BrMisha/F405_pill/VESC_VGT_headers/README.md

https://github.com/vedderb/nrf52_vesc/

Change in main.c:
-#define UART_RX                                                        26
-#define UART_TX                                                        25
+#define UART_RX                                                        13
+#define UART_TX                                                        24
