BrMisha/F405_pill/F405_pill_V1.1/TYPE-C-31-M-12/TYPE-C-31-M-12.step

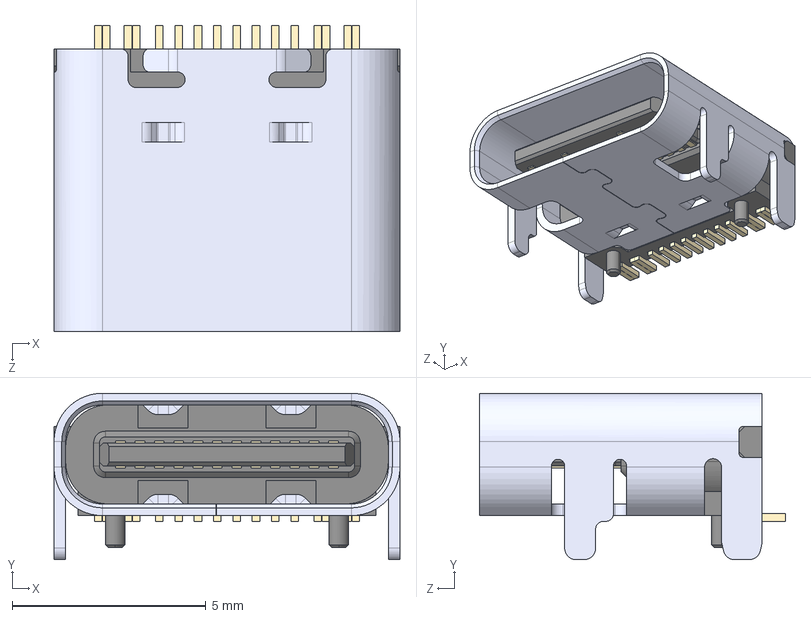
[picture p1: CAD file, 2025-02-10]
F405_pill_V1.1/TYPE-C-31-M-12/TYPE-C-31-M-12.step
8.94 x 4.30 x 7.90 mm
