BrMisha/F405_pill/F405_pill_vgt_V1.0/E73-2G4M08S1C.step

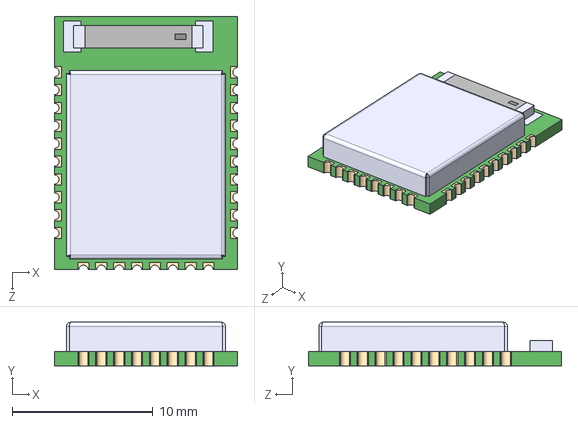
[picture p2: CAD file, 2024-11-16]
F405_pill_vgt_V1.0/E73-2G4M08S1C.step
13.0 x 3.10 x 18.0 mm
