BrMisha/F405_pill/F405_pill_V1.1/F405_pill.kicad_pcb

## KiCad design F405_pill_V1.1/F405_pill.kicad_pcb (2023-09-12)

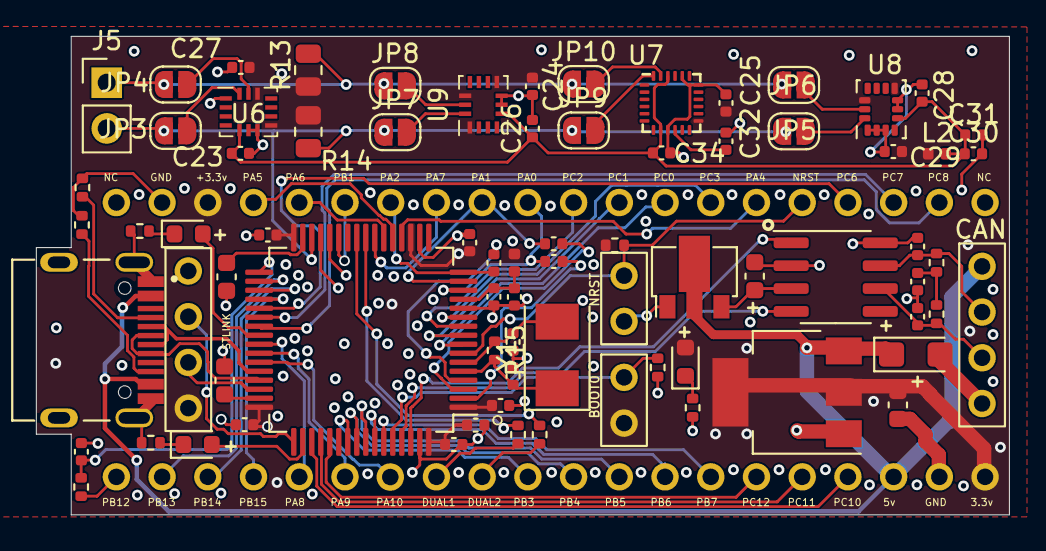
[picture p4: board F405_pill_V1.1/F405_pill.kicad_pcb from above]

Board: 4 copper layers, 54.1 x 26.6 mm, 77 parts (0 on the bottom side), 77 nets.

Parts:
C1: 4u7; C_0402_1005Metric
C2, C4, C7, C10, C12, C17, C18, C19, C23, C24, C25, C26, C27, C28, C29, C32, C34: 100n; C_0402_1005Metric
C3, C6: 20pF; C_0402_1005Metric
C5, C30: 1u; C_0402_1005Metric
C8, C21, C31: 10n; C_0402_1005Metric
C9, C11: 2u2; C_0603_1608Metric
C13: 4.7n; C_0402_1005Metric
C14, C15: 100p; C_0402_1005Metric
C16, C22: 10u; C_0603_1608Metric
C20: 100n; CP_EIA-3216-18_Kemet-A
D1: BLU; LED_0603_1608Metric
D2: GRN; LED_0603_1608Metric
D3: RED; LED_0603_1608Metric
J1, J2: Conn_01x04_Male; my_4_pin
J4: TYPE-C-31-M-12; HRO_TYPE-C-31-M-12
J5: Conn_01x02; PinHeader_1x02_P2.54mm_Vertical
JP1, JP2: Jumper_2_Open; my_2_pin
JP3, JP5, JP7, JP9: SDA; SolderJumper-2_P1.3mm_Open_RoundedPad1.0x1.5mm
JP4, JP6, JP8, JP10: SCL; SolderJumper-2_P1.3mm_Open_RoundedPad1.0x1.5mm
L1, L2: 39n; L_0402_1005Metric
R1, R2: 10k; R_0402_1005Metric
R3, R4: 100Ω; R_0402_1005Metric
R5, R7, R9: 20k; R_0402_1005Metric
R6: 47R; R_0402_1005Metric
R8, R12: 1k; R_0402_1005Metric
R10, R11: 5.1k; R_0402_1005Metric
R13, R14: 2.4K; R_0805_2012Metric
R15: 1M; R_0402_1005Metric
U1: STM32F405RGTx; LQFP-64_10x10mm_P0.5mm
U2: TJA1050T/CM,118; SOIC-8_3.9x4.9mm_P1.27mm
U3: LM1117-3.3; SOT-223-3_TabPin2
U4: STM32F405_pill
U5: HT7550; SOT-89-3
U6: BMI160; Bosch_LGA-14_3x2.5mm_P0.5mm
U7: MPU-9250; InvenSense_QFN-24_3x3mm_P0.4mm
U8: LSM6DS3; LGA-14_3x2.5mm_P0.5mm_LayoutBorder3x4y
U9: BMI270; Bosch_LGA-14_3x2.5mm_P0.5mm
Y1: 8MHz; Crystal_SMD_5032-2Pin_5.0x3.2mm

Connections:
3.3F: C23.1, C26.1, C28.1, C30.1, C31.1, C34.2, L2.2, U6.5 (VDDIO), U7.8 (VDDIO), U7.22 (~CS), U8.5 (VDDIO), U9.5 (VDDIO)
+3.3VA: C5.1, C8.1, L1.2, U1.13 (VDDA)
+3V3: C1.1, C2.1, C4.1, C7.1, C10.1, C12.1, C22.1, C24.1, C25.1, C27.1, C29.1, D1.2 (A), J2.4, JP1.1 (A), L1.1, L2.1, R2.1, R13.1, R14.2, U1.1 (VBAT), U1.19 (VDD), U1.32 (VDD), U1.48 (VDD), U1.64 (VDD), U3.2 (VO), U4.18 (3V3), U4.40 (3V3), U6.8 (VDD), U6.12 (CSB), U7.13 (VDD), U8.8 (VDD), U8.12 (CS), U9.1 (SDO), U9.8 (VDD), U9.12 (CSB)
+5V: C20.1, J1.4, J4.A4B9 (VBUS), J4.B4A9 (VBUS), U3.3 (VI), U4.38 (5V), U5.2 (VI)
DUAL1: R8.1, U4.28 (DUAL1)
DUAL2: R12.1, U4.29 (DUAL2)
GND: C1.2, C2.2, C3.1, C4.2, C5.2, C6.1, C7.2, C8.2, C9.2, C10.2, C11.2, C12.2, C13.2, C14.2, C15.2, C16.2, C20.2, C21.2, C22.2, C23.2, C24.2, C25.2, C26.2, C27.2, C28.2, C29.2, C30.2, C31.2, C32.2, C34.1, J1.1, J2.1, J4.A1B12 (GND), J4.B1A12 (GND), J4.S1 (SHIELD), J4.S2 (SHIELD), J4.S3 (SHIELD), J4.S4 (SHIELD), JP2.2 (B), R1.1, R5.1, R7.1, R9.1, R10.2, R11.2, U1.12 (VSSA), U1.18 (VSS), U1.28 (PB2), U1.63 (VSS), U2.2 (GND), U2.8 (S), U3.1 (GND), U4.19 (GND), U4.39 (GND), U5.1 (GND), U6.1 (SDO), U6.6 (GNDIO), U6.7 (GND), U7.9 (AD0/MISO), U7.18 (GND), U7.20 (RESV_GND), U8.1 (SDO/SA0), U8.2 (SDX), U8.3 (SCX), U8.6 (GND), U8.7 (GND), U9.6 (GNDIO), U9.7 (GND)
NRST: JP2.1 (A), R2.2, U1.7 (NRST), U4.5 (NRST)
unnamed: C13.1, R3.1, R4.2
unnamed: D1.1 (K), R9.2
unnamed: D2.1 (K), R5.2
unnamed: D3.1 (K), R7.2
unnamed: C15.1, J1.2, R4.1, U2.6 (CANL)
unnamed: C14.1, J1.3, R3.2, U2.7 (CANH)
unnamed: J4.A5 (CC1), R10.1
unnamed: J4.B5 (CC2), R11.1
unnamed: JP1.2 (B), R1.2, U1.60 (BOOT0)
unnamed: JP3.2 (B), U6.14 (SDx)
unnamed: JP4.2 (B), U6.13 (SCx)
unnamed: JP5.2 (B), U8.14 (SDA)
unnamed: JP6.2 (B), U8.13 (SCL)
unnamed: JP7.2 (B), U9.14 (SDx)
unnamed: JP8.2 (B), U9.13 (SCx)
unnamed: JP9.2 (B), U7.24 (SDA/MOSI)
unnamed: JP10.2 (B), U7.23 (SCL/SCLK)
unnamed: C3.2, R15.2, U1.5 (PH0), Y1.1
unnamed: C6.2, R15.1, U1.6 (PH1), Y1.2
unnamed: C9.1, U1.31 (VCAP_1)
unnamed: C11.1, U1.47 (VCAP_2)
unnamed: C32.1, U7.10 (REGOUT)
PA0: C17.1, U1.14 (PA0), U4.11 (PA0)
PA1: C18.1, U1.15 (PA1), U4.12 (PA1)
PA2: C19.1, U1.16 (PA2), U4.14 (PA2)
PA4: U1.20 (PA4), U4.6 (PA4)
PA5: U1.21 (PA5), U4.17 (PA5)
PA6: U1.22 (PA6), U4.16 (PA6)
PA7: U1.23 (PA7), U4.13 (PA7)
PA8: U1.41 (PA8), U4.25 (PA8)
PA9: U1.42 (PA9), U4.26 (PA9)
PA10: U1.43 (PA10), U4.27 (PA10)
PA15: D2.2 (A), U1.50 (PA15)
PB1: U1.27 (PB1), U4.15 (PB1)
PB3: U1.55 (PB3), U4.30 (PB3)
PB4: U1.56 (PB4), U4.31 (PB4)
PB5: U1.57 (PB5), U4.32 (PB5)
PB6: U1.58 (PB6), U4.33 (PB6)
PB7: U1.59 (PB7), U4.34 (PB7)
PB8: U1.61 (PB8), U2.4 (RXD)
PB9: U1.62 (PB9), U2.1 (TXD)
PB10: J5.1, JP4.1 (A), JP6.1 (A), JP8.1 (A), JP10.1 (A), R13.2, U1.29 (PB10)
PB11: J5.2, JP3.1 (A), JP5.1 (A), JP7.1 (A), JP9.1 (A), R14.1, U1.30 (PB11)
PB12: C21.1, R6.1, U1.33 (PB12)
PB13: U1.34 (PB13), U4.22 (PB13)
PB14: U1.35 (PB14), U4.23 (PB14)
PB15: U1.36 (PB15), U4.24 (PB15)
PC0: U1.8 (PC0), U4.8 (PC0)
PC1: U1.9 (PC1), U4.9 (PC1)
PC2: U1.10 (PC2), U4.10 (PC2)
PC3: U1.11 (PC3), U4.7 (PC3)
PC4: R8.2, U1.24 (PC4)
PC5: R12.2, U1.25 (PC5)
PC6: U1.37 (PC6), U4.4 (PC6)
PC7: U1.38 (PC7), U4.3 (PC7)
PC8: U1.39 (PC8), U4.2 (PC8)
PC9: D3.2 (A), U1.40 (PC9)
PC10: U1.51 (PC10), U4.37 (PC10)
PC11: U1.52 (PC11), U4.36 (PC11)
PC12: U1.53 (PC12), U4.35 (PC12)
PC13: C17.2, U1.2 (PC13)
PC14: C18.2, U1.3 (PC14)
PC15: C19.2, U1.4 (PC15)
SWCLK: J2.2, U1.49 (PA14)
SWDIO: J2.3, U1.46 (PA13)
USB_D+: J4.A6 (DP1), J4.B6 (DP2), U1.45 (PA12)
USB_D-: J4.A7 (DN1), J4.B7 (DN2), U1.44 (PA11)
VDO_I: C16.1, U2.3 (VCC), U5.3 (VO)
_PB12: R6.2, U4.21 (PB12)
