BrMisha/F405_pill/F405_pill_vgt_V1.0/F405_pill.kicad_pcb

## KiCad design F405_pill_vgt_V1.0/F405_pill.kicad_pcb (2025-01-16)

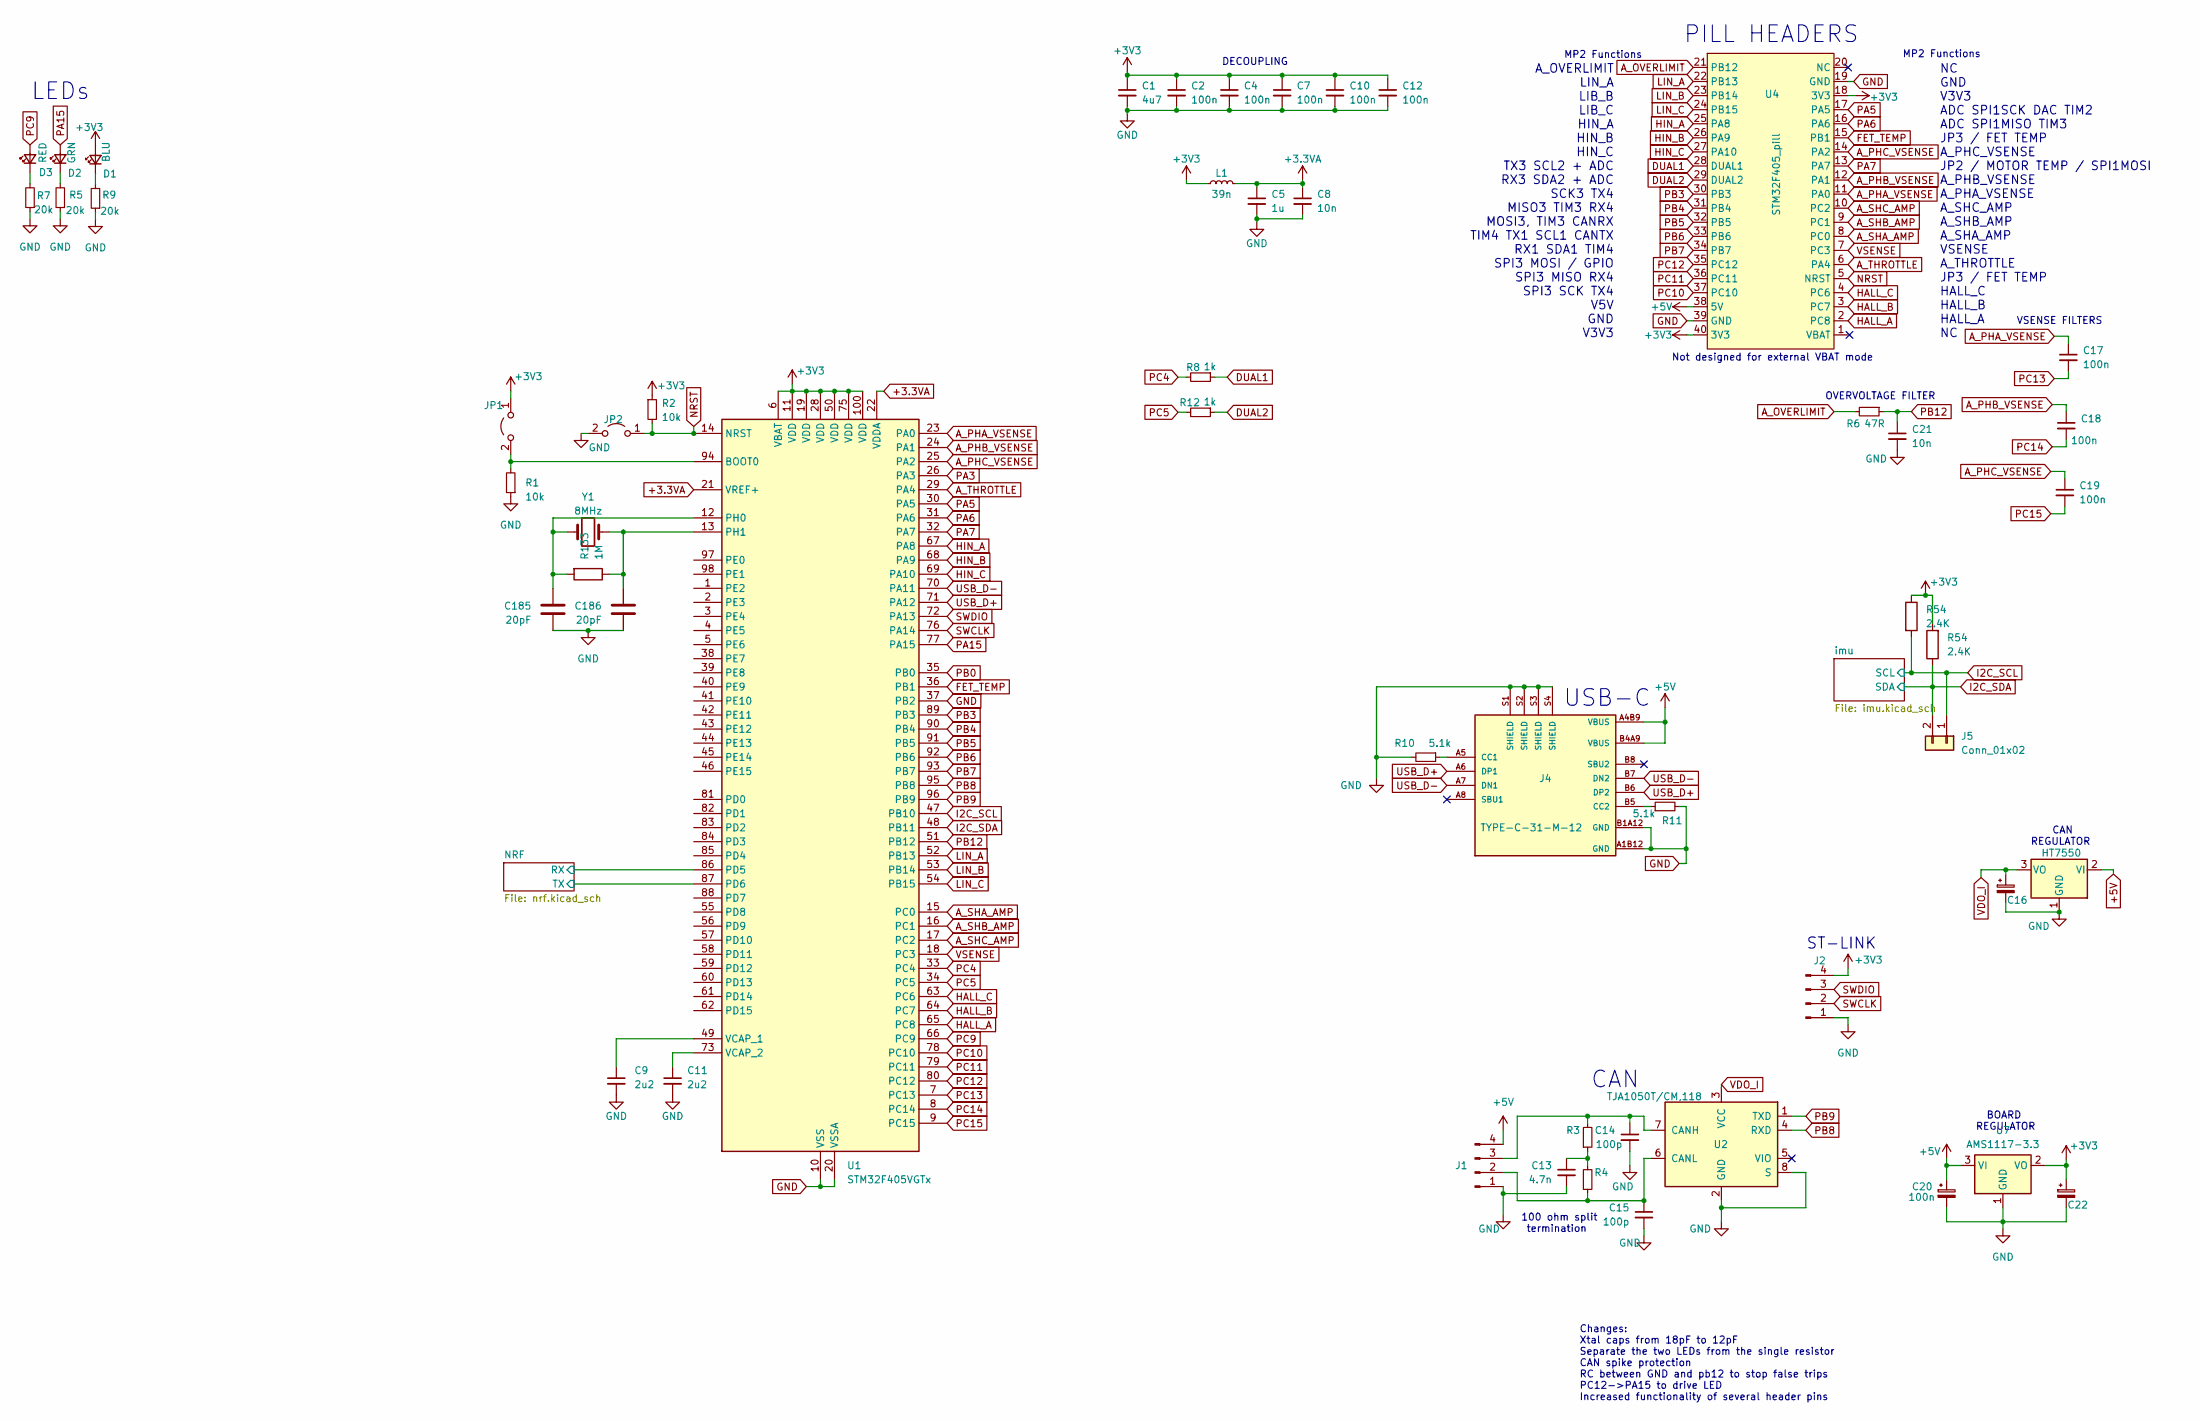
[picture p5: schematic F405_pill.kicad_sch]

Parts:
C1: 4u7; C_0402_1005Metric; LCSC C23733
C2, C4, C7, C10, C12, C17, C18, C19: 100n; C_0402_1005Metric; LCSC C1525
C5: 1u; C_0402_1005Metric; LCSC C52923
C8, C21: 10n; C_0402_1005Metric; LCSC C15195
C9, C11: 2u2; C_0603_1608Metric; LCSC C23630
C13: 4.7n; C_0402_1005Metric; LCSC C1538
C14, C15: 100p; C_0402_1005Metric; LCSC C1546
C16, C22: 10u; C_0603_1608Metric; LCSC C962635
C20: 100n; CP_EIA-3216-18_Kemet-A; LCSC C122257
C185, C186: 20pF; C_0402_1005Metric; MPN C1554
D1: BLU; LED_0603_1608Metric; LCSC C72041
D2: GRN; LED_0603_1608Metric; LCSC C72043
D3: RED; LED_0603_1608Metric; LCSC C2286
J1, J2: Conn_01x04_Male; my_4_pin
J4: TYPE-C-31-M-12; HRO_TYPE-C-31-M-12; PARTREV A; LCSC C165948
J5: Conn_01x02; PinHeader_1x02_P2.54mm_Vertical
JP1, JP2: Jumper_2_Open; my_2_pin
L1: 39n; L_0402_1005Metric; LCSC C26443
R1, R2: 10k; R_0402_1005Metric; LCSC C25744
R3, R4: 100Ω; R_0402_1005Metric; LCSC C25076
R5, R7, R9: 20k; R_0402_1005Metric; LCSC C25765
R6: 47R; R_0402_1005Metric; LCSC C25118
R8, R12: 1k; R_0402_1005Metric; LCSC C11702
R10, R11: 5.1k; R_0402_1005Metric; LCSC C25905
R54: 2.4K; R_0805_2012Metric; MPN C17526
R133: 1M; R_0402_1005Metric; MPN C26083
U1: STM32F405VGTx; LQFP-100_14x14mm_P0.5mm; LCSC C56621
U2: TJA1050T/CM,118; SOIC-8_3.9x4.9mm_P1.27mm; LCSC C6952
U4: STM32F405_pill
U5: HT7550; SOT-89-3; LCSC C16106
U7: AMS1117-3.3; SOT-223-3_TabPin2; MPN C6186
Y1: 8MHz; Crystal_SMD_5032-2Pin_5.0x3.2mm; MPN C115962

Connections:
+3.3VA: C5.1, C8.1, L1.2, U1.21 (VREF+), U1.22 (VDDA)
+3V3: C1.1, C2.1, C4.1, C7.1, C10.1, C12.1, C22.1, D1.2 (A), J2.4, JP1.1 (A), L1.1, R2.1, U1.6 (VBAT), U1.11 (VDD), U1.19 (VDD), U1.28 (VDD), U1.50 (VDD), U1.75 (VDD), U1.100 (VDD), U4.18 (3V3), U4.40 (3V3), U7.2 (VO); also elsewhere on the board
+5V: C20.1, J1.4, J4.A4B9 (VBUS), J4.B4A9 (VBUS), U4.38 (5V), U5.2 (VI), U7.3 (VI)
/NRF/RX: U1.86 (PD5); also elsewhere on the board
/NRF/TX: U1.87 (PD6); also elsewhere on the board
A_OVERLIMIT: R6.2, U4.21 (PB12)
A_PHA_VSENSE: C17.1, U1.23 (PA0), U4.11 (PA0)
A_PHB_VSENSE: C18.1, U1.24 (PA1), U4.12 (PA1)
A_PHC_VSENSE: C19.1, U1.25 (PA2), U4.14 (PA2)
A_SHA_AMP: U1.15 (PC0), U4.8 (PC0)
A_SHB_AMP: U1.16 (PC1), U4.9 (PC1)
A_SHC_AMP: U1.17 (PC2), U4.10 (PC2)
A_THROTTLE: U1.29 (PA4), U4.6 (PA4)
DUAL1: R8.1, U4.28 (DUAL1)
DUAL2: R12.1, U4.29 (DUAL2)
FET_TEMP: U1.36 (PB1), U4.15 (PB1)
GND: C1.2, C2.2, C4.2, C5.2, C7.2, C8.2, C9.2, C10.2, C11.2, C12.2, C13.2, C14.2, C15.2, C16.2, C20.2, C21.2, C22.2, J1.1, J2.1, J4.A1B12 (GND), J4.B1A12 (GND), J4.S1 (SHIELD), J4.S2 (SHIELD), J4.S3 (SHIELD), J4.S4 (SHIELD), JP2.2 (B), R1.1, R5.1, R7.1, R9.1, R10.2, R11.2, U1.10 (VSS), U1.20 (VSSA), U1.27 (VSS), U1.37 (PB2), U1.74 (VSS), U1.99 (VSS), U2.2 (GND), U2.8 (S), U4.19 (GND), U4.39 (GND), U5.1 (GND), U7.1 (GND); also elsewhere on the board
HALL_A: U1.65 (PC8), U4.2 (PC8)
HALL_B: U1.64 (PC7), U4.3 (PC7)
HALL_C: U1.63 (PC6), U4.4 (PC6)
HIN_A: U1.67 (PA8), U4.25 (PA8)
HIN_B: U1.68 (PA9), U4.26 (PA9)
HIN_C: U1.69 (PA10), U4.27 (PA10)
I2C_SCL: J5.1, U1.47 (PB10); also elsewhere on the board
I2C_SDA: J5.2, U1.48 (PB11); also elsewhere on the board
LIN_A: U1.52 (PB13), U4.22 (PB13)
LIN_B: U1.53 (PB14), U4.23 (PB14)
LIN_C: U1.54 (PB15), U4.24 (PB15)
NRST: JP2.1 (A), R2.2, U1.14 (NRST), U4.5 (NRST)
unnamed: C13.1, R3.1, R4.2
unnamed: D1.1 (K), R9.2
unnamed: D2.1 (K), R5.2
unnamed: D3.1 (K), R7.2
unnamed: C15.1, J1.2, R4.1, U2.6 (CANL)
unnamed: C14.1, J1.3, R3.2, U2.7 (CANH)
unnamed: J4.A5 (CC1), R10.1
unnamed: J4.B5 (CC2), R11.1
unnamed: JP1.2 (B), R1.2, U1.94 (BOOT0)
unnamed 41: U1.12 (PH0), Y1.1; also elsewhere on the board
unnamed 42: U1.13 (PH1), Y1.2; also elsewhere on the board
unnamed: C9.1, U1.49 (VCAP_1)
unnamed: C11.1, U1.73 (VCAP_2)
PA3: U1.26 (PA3)
PA5: U1.30 (PA5), U4.17 (PA5)
PA6: U1.31 (PA6), U4.16 (PA6)
PA7: U1.32 (PA7), U4.13 (PA7)
PA15: D2.2 (A), U1.77 (PA15)
PB0: U1.35 (PB0)
PB3: U1.89 (PB3), U4.30 (PB3)
PB4: U1.90 (PB4), U4.31 (PB4)
PB5: U1.91 (PB5), U4.32 (PB5)
PB6: U1.92 (PB6), U4.33 (PB6)
PB7: U1.93 (PB7), U4.34 (PB7)
PB8: U1.95 (PB8), U2.4 (RXD)
PB9: U1.96 (PB9), U2.1 (TXD)
PB12: C21.1, R6.1, U1.51 (PB12)
PC4: R8.2, U1.33 (PC4)
PC5: R12.2, U1.34 (PC5)
PC9: D3.2 (A), U1.66 (PC9)
PC10: U1.78 (PC10), U4.37 (PC10)
PC11: U1.79 (PC11), U4.36 (PC11)
PC12: U1.80 (PC12), U4.35 (PC12)
PC13: C17.2, U1.7 (PC13)
PC14: C18.2, U1.8 (PC14)
PC15: C19.2, U1.9 (PC15)
SWCLK: J2.2, U1.76 (PA14)
SWDIO: J2.3, U1.72 (PA13)
USB_D+: J4.A6 (DP1), J4.B6 (DP2), U1.71 (PA12)
USB_D-: J4.A7 (DN1), J4.B7 (DN2), U1.70 (PA11)
VDO_I: C16.1, U2.3 (VCC), U5.3 (VO)
VSENSE: U1.18 (PC3), U4.7 (PC3)

Notes on the sheet:
CAN
NC GND V3V3 ADC SPI1SCK DAC TIM2 ADC SPI1MISO TIM3 JP3 / FET TEMP A_PHC_VSENSE JP2 / MOTOR TEMP / SPI1MOSI A_PHB_VSENSE A_PHA_VSENSE A_SHC_AMP A_SHB_AMP A_SHA_AMP VSENSE A_THROTTLE JP3 / FET TEMP HALL_C HALL_B HALL_A NC
ST-LINK
Changes: Xtal caps from 18pF to 12pF Separate the two LEDs from the single resistor CAN spike protection RC between GND and pb12 to stop false trips PC12->PA15 to drive LED Increased functionality of several header pins
A_OVERLIMIT LIN_A LIB_B LIB_C HIN_A HIN_B HIN_C TX3 SCL2 + ADC RX3 SDA2 + ADC SCK3 TX4 MISO3 TIM3 RX4 MOSI3, TIM3 CANRX TIM4 TX1 SCL1 CANTX RX1 SDA1 TIM4 SPI3 MOSI / GPIO SPI3 MISO RX4 SPI3 SCK TX4 V5V GND V3V3
BOARD REGULATOR
PILL HEADERS
MP2 Functions
CAN REGULATOR
VSENSE FILTERS
OVERVOLTAGE FILTER
LEDs
USB-C
Not designed for external VBAT mode
DECOUPLING
100 ohm split termination

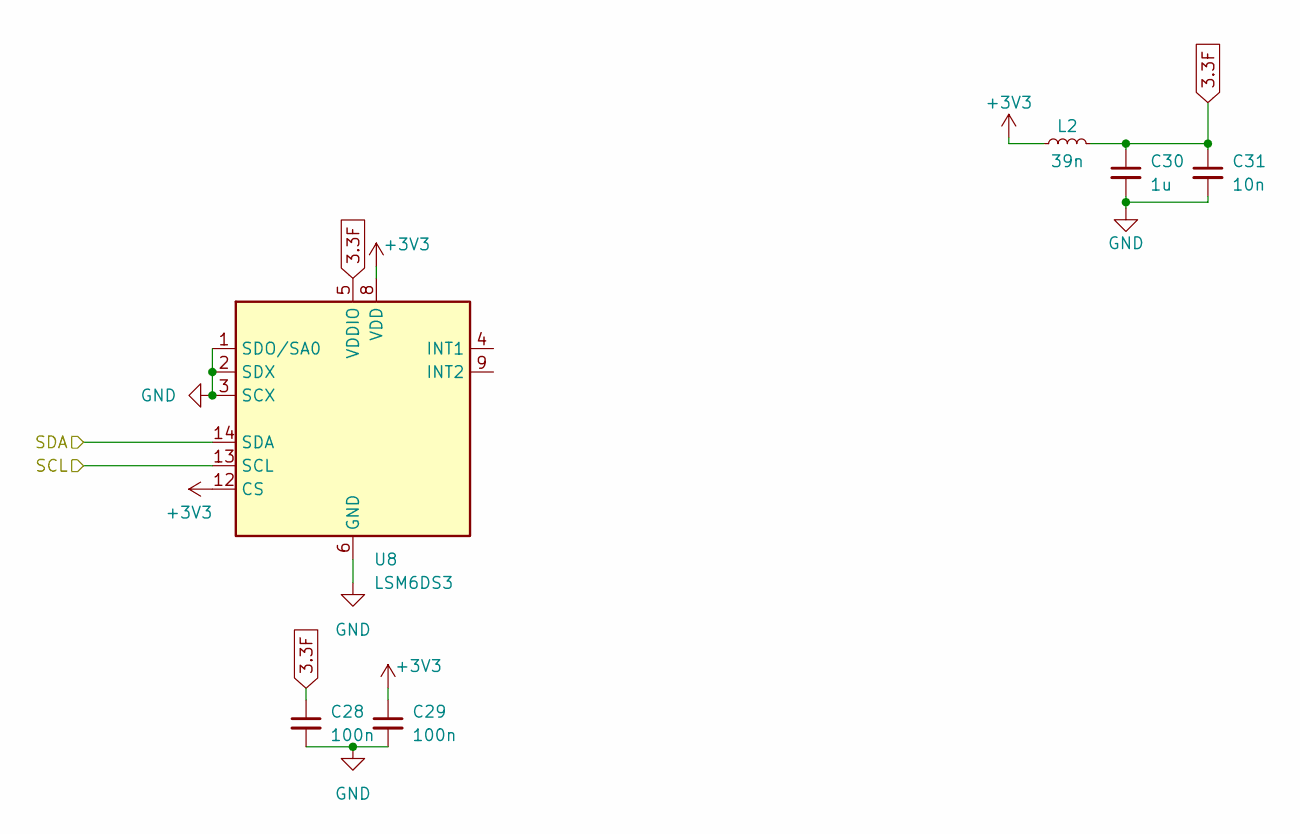
[picture p6: schematic imu.kicad_sch]

Parts:
C28, C29: 100n; C_0402_1005Metric; LCSC C1525
C30: 1u; C_0402_1005Metric; LCSC C52923
C31: 10n; C_0402_1005Metric; LCSC C15195
L2: 39n; L_0402_1005Metric; LCSC C26443
U8: LSM6DS3; LGA-14_3x2.5mm_P0.5mm_LayoutBorder3x4y; MPN C95230

Connections:
3.3F: C28.1, C30.1, C31.1, L2.2, U8.5 (VDDIO)
+3V3: C29.1, L2.1, U8.8 (VDD), U8.12 (CS); also elsewhere on the board
GND: C28.2, C29.2, C30.2, C31.2, U8.1 (SDO/SA0), U8.2 (SDX), U8.3 (SCX), U8.6 (GND), U8.7 (GND); also elsewhere on the board
I2C_SCL: U8.13 (SCL); also elsewhere on the board
I2C_SDA: U8.14 (SDA); also elsewhere on the board

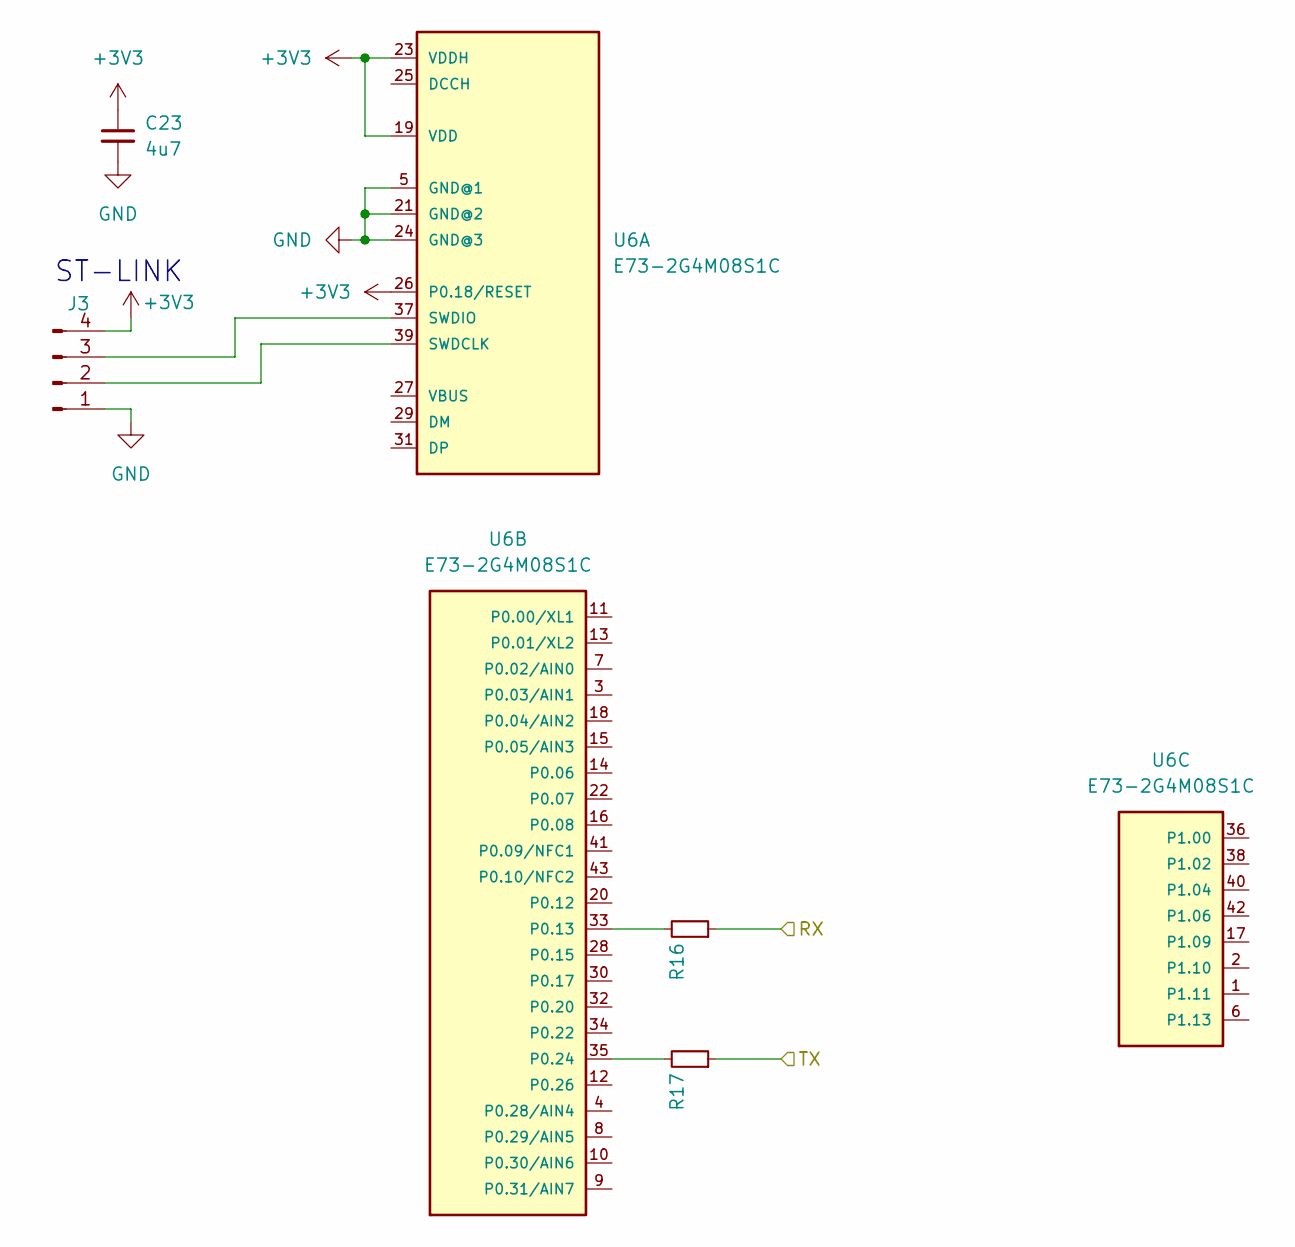
[picture p7: schematic nrf.kicad_sch]

Parts:
C23: 4u7; C_0402_1005Metric; LCSC C23733
J3: Conn_01x04_Male; PinHeader_1x04_P2.54mm_Vertical
R16, R17: 100Ω; R_0402_1005Metric; LCSC C25076
U6: E73-2G4M08S1C

Connections:
+3V3: C23.1, J3.4, U6.19 (VDD), U6.23 (VDDH), U6.26 (P0.18/RESET); also elsewhere on the board
/NRF/RX: R16.1; also elsewhere on the board
/NRF/TX: R17.1; also elsewhere on the board
GND: C23.2, J3.1, U6.5 (GND@1), U6.21 (GND@2), U6.24 (GND@3); also elsewhere on the board
unnamed: J3.2, U6.39 (SWDCLK)
unnamed: J3.3, U6.37 (SWDIO)
unnamed: R16.2, U6.33 (P0.13)
unnamed: R17.2, U6.35 (P0.24)

Notes on the sheet:
ST-LINK

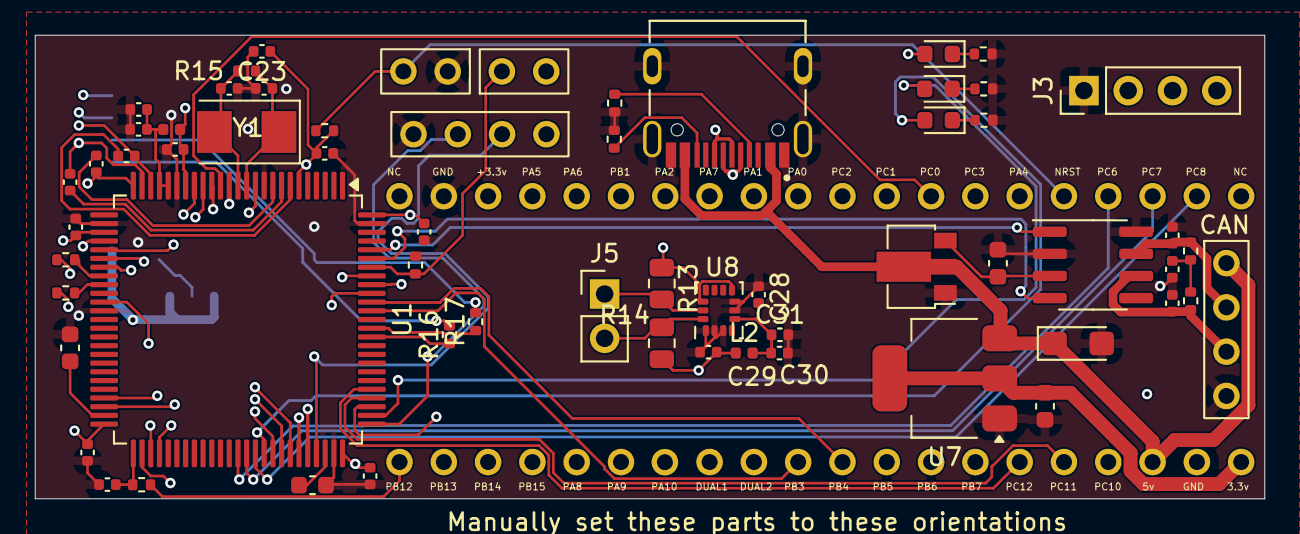
[picture p8: board F405_pill_vgt_V1.0/F405_pill.kicad_pcb from above]

Board: 4 copper layers, 70.5 x 26.6 mm, 64 parts (1 on the bottom side), 74 nets.

Other parts of the board:
C3, C6: 20pF; C_0402_1005Metric
R13, R14: 2.4K; R_0805_2012Metric
R15: 1M; R_0402_1005Metric

Their connections:
+3V3: R13.1, R14.2; also elsewhere on the board
GND: C3.1, C6.1; also elsewhere on the board
I2C_SCL: R13.2; also elsewhere on the board
I2C_SDA: R14.1; also elsewhere on the board
unnamed 41: C3.2, R15.2; also elsewhere on the board
unnamed 42: C6.2, R15.1; also elsewhere on the board
