BrMisha/F405_pill/F405_pill.ioc

Mcu.UserName=STM32F405VGTx
PA0-WKUP.GPIO_Label=A_PHA_VSENSE
PA0-WKUP.Signal=GPIO_Input
PA1.GPIO_Label=A_PHB_VSENSE
PA1.Signal=GPIO_Input
PA10.GPIO_Label=HIN_C
PA10.Signal=GPIO_Output
PA11.Signal=USB_OTG_FS_DM
PA12.Signal=USB_OTG_FS_DP
PA2.GPIO_Label=A_PHC_VSENSE
PA2.Signal=GPIO_Input
PA4.GPIO_Label=A_THROTTLE
PA4.Signal=GPIO_Analog
PA8.GPIO_Label=HIN_A
PA8.Signal=GPIO_Output
PA9.GPIO_Label=HIN_B
PA9.Signal=GPIO_Output
PB1.GPIO_Label=FET_TEMP
PB1.Signal=GPIO_Analog
PB10.Signal=I2C2_SCL
PB11.Signal=I2C2_SDA
PB12.GPIO_Label=A_OVERLIMIT
PB12.Signal=GPIO_Analog
PB13.GPIO_Label=LIN_A
PB13.Signal=GPIO_Output
PB14.GPIO_Label=LIN_B
PB14.Signal=GPIO_Output
PB15.GPIO_Label=LIN_C
PB15.Signal=GPIO_Output
PC0.GPIO_Label=A_SHA_AMP
PC0.Signal=GPIO_Analog
PC1.GPIO_Label=A_SHB_AMP
PC1.Signal=GPIO_Analog
PC10.Signal=USART3_TX
PC11.Signal=USART3_RX
PC2.GPIO_Label=A_SHC_AMP
PC2.Signal=GPIO_Analog
PC3.GPIO_Label=VSENSE
PC3.Signal=GPIO_Analog
PC6.GPIO_Label=HALL_C
PC6.Signal=GPIO_Input
PC7.GPIO_Label=HALL_B
PC7.Signal=GPIO_Input
PC8.GPIO_Label=HALL_A
PC8.Signal=GPIO_Input
PD5.GPIO_Label=NRF_TX
PD5.Signal=USART2_TX
PD6.GPIO_Label=NRF_RX
PD6.Signal=USART2_RX
