BrMisha/F405_pill/(commit log)

2023-09-12 add imu
    [F405_pill.kicad_pcb, F405_pill.kicad_sch, imu.kicad_sch]
2023-09-12 removed one imu
    [imu.kicad_sch]
2023-09-12 add bmi270
    [F405_pill.kicad_pcb, imu.kicad_sch]
2023-09-12 fixed for prodaction
    [F405_pill.kicad_pcb, F405_pill.kicad_sch]
2024-11-15 add MCU
    [F405_pill.kicad_pcb, F405_pill.kicad_sch, imu.kicad_sch]
2024-11-16 add E73
    [E73-2G4M08S1C.step, nrf.kicad_sch]
2024-11-16 Schematic is finished
    [F405_pill.kicad_pcb, F405_pill.kicad_sch, nrf.kicad_sch]
2024-11-16 Rarticly routed
    [F405_pill.kicad_pcb]
2024-11-16 pcb finished
    [F405_pill.kicad_pcb]
2025-01-16 Fixed pin
    [F405_pill.kicad_pcb, F405_pill.kicad_sch]
2025-01-16 updated for prodaction
    [F405_pill.kicad_pcb, F405_pill.kicad_sch, imu.kicad_sch, nrf.kicad_sch]
2025-02-10 add old version
    [F405_PILL_BOM.xlsx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]
2025-05-10 rised current
2025-06-06 updated current
