BrMisha/F405_pill/(notices)

Notices in the files:
VESC_VGT_headers/hw_MP2VGT.h:
The VESC firmware is free software: you can redistribute it and/or modify
it under the terms of the GNU General Public License as published byNTC_RES
F405_pill_V1.1/F405_pill.kicad_pcb:
LICENSE: BSD
